angiadevices/Jhankaar/3D Model/MICRO-USB-SMD_10103594-0001LF.step

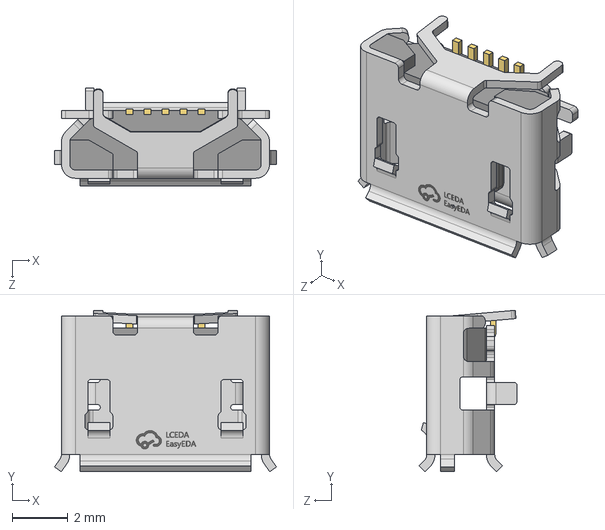
[picture p1: CAD file, 2025-10-25]
3D Model/MICRO-USB-SMD_10103594-0001LF.step
8.00 x 5.82 x 3.52 mm
