angiadevices/Jhankaar/3D Model/PJ-301M-3-B/PJ-301M-3-B.stp

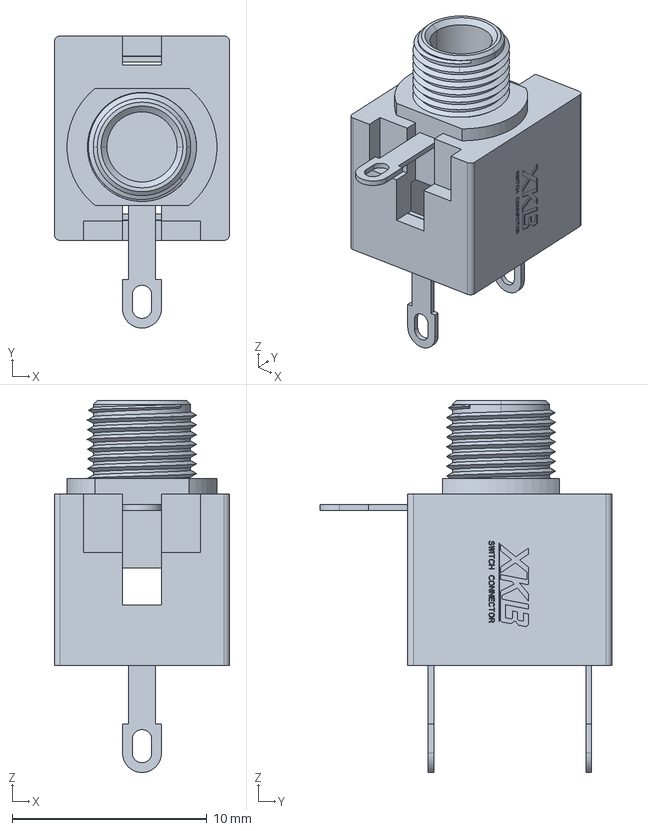
[picture p2: CAD file, 2025-10-25]
3D Model/PJ-301M-3-B/PJ-301M-3-B.stp
9.00 x 15.0 x 19.1 mm
