angiadevices/Jhankaar/3D Model/SW-TH_D6R90F1LFS.step

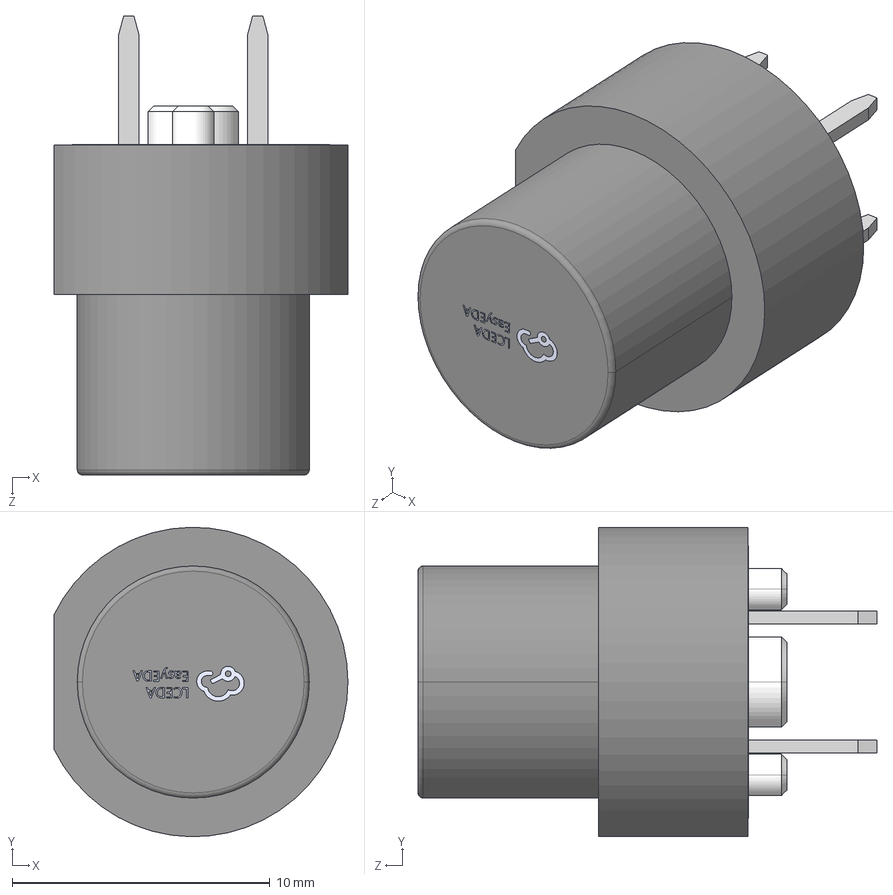
[picture p3: CAD file, 2025-10-25]
3D Model/SW-TH_D6R90F1LFS.step
11.4 x 12.0 x 17.8 mm
