angiadevices/Jhankaar/3D Model/RES-TH_RK09K113004U.step

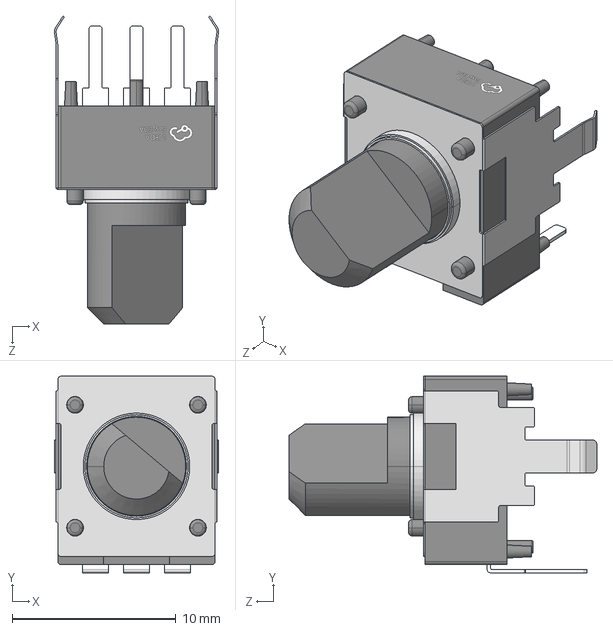
[picture p4: CAD file, 2025-10-25]
3D Model/RES-TH_RK09K113004U.step
10.0 x 12.0 x 18.8 mm
