angiadevices/Jhankaar/3D Model/WQP-PJ398SM.step

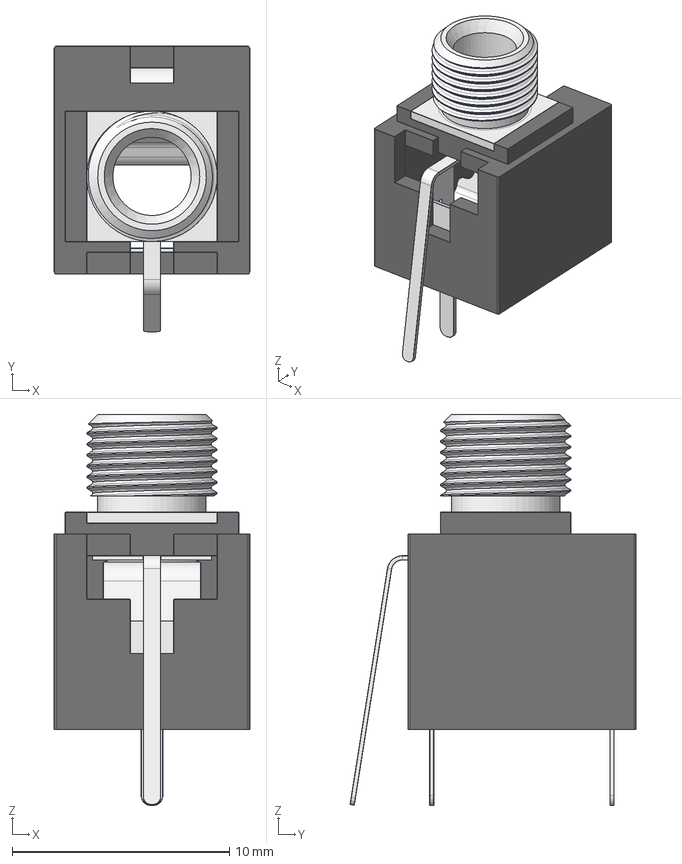
[picture p5: CAD file, 2025-10-25]
3D Model/WQP-PJ398SM.step
9.00 x 13.2 x 18.0 mm
Pin_3
Pin_2
Pin_1
Socket
