angiadevices/Jhankaar/PCB_Ectoscore.kicad_pcb

## KiCad design PCB_Ectoscore.kicad_pcb (2025-10-25)

Schematic: PCB_Ectoscore.kicad_sch

Parts:
C1, C2, C10, C11, C13, C14, C15, C16, C17, C19, C20, C22, C24, C25, C26, C30, C31, C32, C35, C36, C37, C40, C42, C45, C46, C47, C49, C51, C52, C53, C54, C55, C56, C57, C58, C59, C60, C61, C62, C63, C64, C65, C66, C67, C68, C71, C72, C73, C74, C75, C76, C77: 100nF; C_0603_1608Metric_Pad1.08x0.95mm_HandSolder; Manufacturer Part CC0603KRX7R9BB104
C3, C12: 1uF; CP_Elec_4x5.4; Manufacturer Part CA45-A025K105T
C4, C9: 10uF; C_0805_2012Metric; Manufacturer Part GRM21BR61H106KE43L
C5, C6, C48, C50, C69: 10uF; CP_Elec_6.3x5.4; Manufacturer Part RVT1H100M0605
C7, C8: 15pF; C_0603_1608Metric_Pad1.08x0.95mm_HandSolder; Manufacturer Part CC0603KRNPO9BN150
C21, C23: 1uF; C_0603_1608Metric_Pad1.08x0.95mm_HandSolder; Manufacturer Part CC0603KRX7R9BB105
C34, C44, C78, C79, C80: 100pF; C_0603_1608Metric_Pad1.08x0.95mm_HandSolder; Manufacturer Part CC0603KRX7R9BB101
C38, C39: 2.2uF; C_0603_1608Metric_Pad1.08x0.95mm_HandSolder; Manufacturer Part GRM188Z71E225KE43D
C41, C43: 1nF; C_0603_1608Metric_Pad1.08x0.95mm_HandSolder; Manufacturer Part CC0603KRX7R9BB102
C70: 22uF; CP_Elec_6.3x5.4; Manufacturer Part RVT1H220M0605
D1, D2, D3, D24: 1N5819WS; D_SOD-323_HandSoldering; Manufacturer Part 1N5819WS
D5, D6, D7, D8, D9, D10, D11, D12, D13, D14, D15, D16, D17, D18, D19, D20, D21, D22: WS2812B-2020; LED_WS2812B-2020_PLCC4_2.0x2.0mm; Manufacturer Part WS2812B-2020
J1: Conn_02x05_Odd_Even; IDC-Header_2x05_P2.54mm_Vertical; Manufacturer Part ZX-IDC2.54-2-5PZZ
J2: Conn_01x03; PinHeader_1x03_P2.54mm_Vertical; Manufacturer Part PZ254-1-03-Z-8.5
J3, J5, J6, J7, J8, J9, J10, J11: PJ-301M-3-B; Jack_3.5mm_QingPu_WQP-PJ398SM_Vertical; Manufacturer Part PJ-301M-3-B
J12: PJS008U-3000-0; PJS008U30000; Manufacturer_Part_Number PJS008U-3000-0; Mouser Part Number 945-PJS008U-3000-0
J13, J14: Conn_01x03; HDR-TH_3P-P2.54-V-M-1; Manufacturer Part PZ254-1-03-Z-8.5
LED1, LED2, LED3, LED4, LED5, LED6: LED-0603_R; LED0603-R-RD_RED; Part Number PCM5100AQPWRQ1
Q1: MMBT3904; SOT-23; Manufacturer Part MMBT3904LT1G
R1, R2, R5, R29, R36, R42, R47, R50, R57, R58, R64, R81, R82, R83: 1kΩ; R_0603_1608Metric_Pad0.98x0.95mm_HandSolder; Manufacturer Part 0603WAF1001T5E
R3, R4, R8, R52, R55, R71: 10kΩ; R_0603_1608Metric_Pad0.98x0.95mm_HandSolder; Manufacturer Part 0603WAF1002T5E
R6, R9: 1k; R_0603_1608Metric_Pad0.98x0.95mm_HandSolder; Manufacturer Part 0603WAF1001T5E
R7: 0R; R_0603_1608Metric_Pad0.98x0.95mm_HandSolder; Manufacturer Part 0603WAF0000T5E
R10, R15, R68, R69, R70: 10kΩ; POT_TH_Alps_RK09K_Single_Vertical; Manufacturer Part RK09K1130A8G
R27, R28: 27; R_0603_1608Metric_Pad0.98x0.95mm_HandSolder; Manufacturer Part 0603WAF270JT5E
R48, R49: 5.1kΩ; R_0603_1608Metric_Pad0.98x0.95mm_HandSolder; Manufacturer Part 0603WAF5101T5E
R51, R54, R65: 2.2kΩ; R_0603_1608Metric_Pad0.98x0.95mm_HandSolder; Manufacturer Part 0603WAF2201T5E
R53, R56, R72, R77, R80: 33kΩ; R_0603_1608Metric_Pad0.98x0.95mm_HandSolder; Manufacturer Part 0603WAF3302T5E
R59: 200Ω; R_0603_1608Metric_Pad0.98x0.95mm_HandSolder; Manufacturer Part 0603WAF2000T5E
R60, R62: 18kΩ; R_0603_1608Metric_Pad0.98x0.95mm_HandSolder; Manufacturer Part 0603WAF1802T5E
R61, R63: 9.1kΩ; R_0603_1608Metric_Pad0.98x0.95mm_HandSolder; Manufacturer Part 0603WAF9101T5E
R66, R67, R73, R76, R79: 100kΩ; R_0603_1608Metric_Pad0.98x0.95mm_HandSolder; Manufacturer Part 0603WAF1003T5E
R74, R75, R78: 200kΩ; R_0603_1608Metric_Pad0.98x0.95mm_HandSolder; Manufacturer Part 0603WAF2003T5E
SW1, SW2, SW3: TL1105SPF100Q; KEY-TH_4P-L6.0-W6.0-P4.50-LS7.5; Manufacturer Part TL1105SPF100Q
SW4: ML6-H2T2BQA; SW-TH_ML6-H2XX; Manufacturer Part ML6-H2T2BQA
SW5, SW6: SW_Push; SW_SPST_CK_RS282G05A3; Manufacturer Part RS282G05A3SM
TP1, TP2, TP3, TP4, TP5, TP6, TP7, TP8: TestPoint; TestPoint_Pad_D1.5mm; Manufacturer Part N/A; not fitted
U1: L7805; TO-252-2; Manufacturer Part L7805CDT-TR
U2: NCP1117-3.3_SOT223; SOT-223-3_TabPin2; Manufacturer Part NCP1117ST33T3G
U7: W25Q128JVS; SOIC-8_5.3x5.3mm_P1.27mm; Manufacturer Part W25Q128JVSIQ
U11: RP2040; RP2040-QFN-56; Manufacturer Part RP2040
U15: 12402012E212A; USB-SMD_TYPE-C16PIN-1; Manufacturer Part 12402012E212A; LCSC Part C5150972
U16: PCM5100AQPWRQ1; TSSOP-20_4.4x6.5mm_P0.65mm; Manufacturer Part PCM5100AQPWRQ1
U17, U18: TL072HIDR; SOIC-8_3.9x4.9mm_P1.27mm; Manufacturer Part TL072HIDR
U19: TLP2361(TPL,E(T; SO-5-6_4.55x3.7mm_P1.27mm; Manufacturer Part TLP2361(TPL,E(T
U20: MCP3208T-CI/SL; SOIC-16_3.9x9.9mm_P1.27mm; Manufacturer Part MCP3208T-CI/SL
U21: MCP1804x-5002xMB; SOT-89-3; Manufacturer Part MCP1804T-5002I/MB
U22: LM4040DIM3-10.0/NOPB; SOT-23; Manufacturer Part LM4040DIM3-10.0/NOPB
U23: MCP6004T-I/ST; TSSOP-14_4.4x5mm_P0.65mm; Manufacturer Part MCP6004T-I/ST
Y1: ABM8-272-T3; Crystal_SMD_3225-4Pin_3.2x2.5mm; Manufacturer Part ABM8-272-T3

Connections:
3.3V: C9.1, C12.1, C15.1, C22.1, C23.1, C24.1, C25.1, C26.1, C30.1, C31.1, C32.1, C42.2, C49.2, C50.1, C51.2, C52.2, C53.2, C54.2, C55.2, C56.2, C57.2, C58.2, C59.2, C60.2, C61.2, C62.2, C63.2, C64.2, C65.2, C66.2, C67.2, C68.2, D5.4 (VDD), D6.4 (VDD), D7.4 (VDD), D8.4 (VDD), D9.4 (VDD), D10.4 (VDD), D11.4 (VDD), D12.4 (VDD), D13.4 (VDD), D14.4 (VDD), D15.4 (VDD), D16.4 (VDD), D17.4 (VDD), D18.4 (VDD), D19.4 (VDD), D20.4 (VDD), D21.4 (VDD), D22.4 (VDD), J12.4 (VDD), R3.2, R4.2, R7.1, R8.2, R42.1, R47.1, R67.2, R81.1, R82.1, R83.2, TP2.1, U2.2 (VO), U7.8 (VCC), U11.1 (IOVDD), U11.10 (IOVDD), U11.22 (IOVDD), U11.33 (IOVDD), U11.42 (IOVDD), U11.43 (ADC_AVDD), U11.44 (VREG_IN), U11.48 (USB_VDD), U11.49 (IOVDD), U16.11 (FLT), U16.17 (XSMT), U16.20 (DVDD), U19.6 (VDD)
5V: C3.1, D1.2 (A), TP3.1, U1.3 (OUT)
10NEG: C71.2, R65.2, R74.2, R75.2, R78.2, U22.1 (K)
12POS: C10.2, C13.2, C46.2, C47.2, C70.1, D2.1 (K), TP4.1, U1.1 (IN), U17.8 (V+), U18.8 (V+), U21.3 (IN)
+1V1: C19.1, C20.1, C21.1, U11.23 (DVDD), U11.45 (VREG_VOUT), U11.50 (DVDD)
+3V3_A: C17.2, C35.2, C36.2, C48.1, C69.1, C77.2, R10.1, R15.1, R68.1, R69.1, R70.1, TP7.1, U16.1 (CPVDD), U16.8 (AVDD), U20.15 (Vref), U20.16 (Vdd), U21.1 (OUT), U23.4 (V+)
-12V: C11.1, C14.1, C40.2, C45.2, D3.2 (A), R65.1, TP5.1, U17.4 (V-), U18.4 (V-)
/QSPI_SCLK: U7.6 (CLK), U11.52 (QSPI_SCLK)
/QSPI_SD0: U7.5 (DI(IO0)), U11.53 (QSPI_SD0)
/QSPI_SD1: U7.2 (DO(IO1)), U11.55 (QSPI_SD1)
/QSPI_SD2: U7.3 (IO2), U11.54 (QSPI_SD2)
/QSPI_SD3: U7.7 (IO3), U11.51 (QSPI_SD3)
/QSPI_SS: R6.1, R7.2, U7.1 (~CS), U11.56 (QSPI_SS)
/RUN: SW6.2, U11.26 (RUN)
/SWCLK: J13.1, U11.24 (SWCLK)
/SWD: J13.2, U11.25 (SWD)
/USB_D+: R27.1, U15.A6 (D+), U15.B6 (D+)
/USB_D-: R28.1, U15.A7 (D-), U15.B7 (D-)
/XIN: C7.1, U11.20 (XIN), Y1.1
/XOUT: R9.1, U11.21 (XOUT)
/~USB_BOOT: R6.2, SW5.2
ADC_CSN: U11.12 (GPIO9), U20.10 (~CS/SHDN)
ADC_RX: U11.11 (GPIO8), U20.12 (Dout)
ADC_SCLK: U11.13 (GPIO10), U20.13 (CLK)
ADC_TX: U11.14 (GPIO11), U20.11 (Din)
BTN_BANK: C16.2, R5.2, R8.1, U11.31 (GPIO20)
BTN_MODE: C1.2, R1.2, R3.1, U11.2 (GPIO0)
BTN_MULT: C2.2, R2.2, R4.1, U11.3 (GPIO1)
BTN_TAP_TEMPO: SW4.1, SW4.2, U11.4 (GPIO2)
CLOCK_IN: Q1.3 (C), R67.1, U11.17 (GPIO14)
CLOCK_OUT: R29.1, U11.30 (GPIO19), U18.3 (+)
CV_AMEN: C80.1, R80.1, U20.3 (CH2), U23.14
CV_BREAK: C79.1, R77.1, U20.6 (CH5), U23.8
CV_SAMPLE: C78.1, R72.1, U20.8 (CH7), U23.7
DAC_BCK: U11.32 (GPIO21), U16.13 (BCK)
DAC_DIN: U11.35 (GPIO23), U16.14 (DIN)
DAC_LRCK: U11.34 (GPIO22), U16.15 (LRCK)
DAC_OUTL: R51.2, U16.6 (OUTL)
DAC_OUTR: R54.2, U16.7 (OUTR)
GND: C1.1, C2.1, C3.2, C4.2, C5.2, C6.1, C7.2, C8.2, C9.2, C10.1, C11.2, C12.2, C13.1, C14.2, C15.2, C16.1, C17.1, C19.2, C20.2, C21.2, C22.2, C23.2, C24.2, C25.2, C26.2, C30.2, C31.2, C32.2, C35.1, C36.1, C37.1, C39.1, C40.1, C41.1, C42.1, C43.1, C45.1, C46.1, C47.1, C48.2, C49.1, C50.2, C51.1, C52.1, C53.1, C54.1, C55.1, C56.1, C57.1, C58.1, C59.1, C60.1, C61.1, C62.1, C63.1, C64.1, C65.1, C66.1, C67.1, C68.1, C69.2, C70.2, C71.1, C72.1, C73.1, C74.1, C75.1, C76.1, C77.1, D5.2 (VSS), D6.2 (VSS), D7.2 (VSS), D8.2 (VSS), D9.2 (VSS), D10.2 (VSS), D11.2 (VSS), D12.2 (VSS), D13.2 (VSS), D14.2 (VSS), D15.2 (VSS), D16.2 (VSS), D17.2 (VSS), D18.2 (VSS), D19.2 (VSS), D20.2 (VSS), D21.2 (VSS), D22.2 (VSS), J1.3, J1.4, J1.5, J1.6, J1.7, J1.8, J2.3, J3.S, J5.S, J6.S, J7.S, J8.S, J9.S, J10.S, J11.S, J12.6 (VSS), J12.MH1, J12.MH2, J13.3, J14.3, LED1.2 (C), LED2.2 (C), Q1.2 (E), R10.3, R15.3, R48.1, R49.1, R60.1, R62.1, R68.3, R69.3, R70.3, SW1.1, SW1.2, SW2.1, SW2.2, SW3.1, SW3.2, SW4.3, SW4.4, SW5.1, SW6.1, TP1.1, TP6.1, TP8.1, U1.2 (GND), U2.1 (GND), U7.4 (GND), U11.19 (TESTEN), U11.57 (GND), U15.17, U15.18, U15.19, U15.20, U15.A1B12 (GND), U15.B1A12 (GND), U16.3 (CPGND), U16.9 (AGND), U16.10 (DEMP), U16.12 (SCK), U16.16 (FMT), U16.19 (DGND), U17.3 (+), U17.5 (+), U19.4 (GND), U20.9 (DGND), U20.14 (AGND), U21.2 (GND), U22.2 (A), U23.5 (+), U23.10 (+), U23.11 (V-), U23.12 (+), Y1.2, Y1.4
INPUT_DETECT: J9.T, J10.T, J11.T, R71.1, R73.2, R76.2, R79.2
INPUT_DETECT_UNBUFFER: U11.27 (GPIO16), U23.3 (+)
KNOB_AMEN: C76.2, R70.2, U20.1 (CH0)
KNOB_AMEN_ATTEN: C75.2, R69.2, U20.2 (CH1)
KNOB_BREAK: C74.2, R68.2, U20.4 (CH3)
KNOB_GRIMOIRE: C73.2, R10.2, U20.5 (CH4)
KNOB_SAMPLE: C72.2, R15.2, U20.7 (CH6)
LED_MODE1: LED3.2 (C), U11.8 (GPIO6)
LED_MODE2: LED4.2 (C), U11.15 (GPIO12)
LED_MODE3: LED6.2 (C), U11.28 (GPIO17)
LED_MODE4: LED5.2 (C), U11.16 (GPIO13)
LED_TAP_TEMPO: SW4.L2, U11.5 (GPIO3)
MIDI: U11.18 (GPIO15), U19.5 (VO)
unnamed: C8.1, R9.2, Y1.3
unnamed: C34.1, R50.1, R53.1, U17.1
unnamed: C41.2, R51.1, R52.2
unnamed: C43.2, R54.1, R55.2
unnamed: C44.1, R56.1, R57.1, U17.7
unnamed: C4.1, D1.1 (K), D24.1 (K), U2.3 (VI)
unnamed: C5.1, D2.2 (A), J1.9, J1.10
unnamed: C6.2, D3.1 (K), J1.1, J1.2
unnamed: D5.1 (DOUT), D6.3 (DIN)
unnamed: D6.1 (DOUT), D7.3 (DIN)
unnamed: D7.1 (DOUT), D8.3 (DIN)
unnamed: D8.1 (DOUT), D9.3 (DIN)
unnamed: D9.1 (DOUT), D10.3 (DIN)
unnamed: D10.1 (DOUT), D11.3 (DIN)
unnamed: D11.1 (DOUT), D12.3 (DIN)
unnamed: D12.1 (DOUT), D13.3 (DIN)
unnamed: D13.1 (DOUT), D14.3 (DIN)
unnamed: D14.1 (DOUT), D15.3 (DIN)
unnamed: D15.1 (DOUT), D16.3 (DIN)
unnamed: D16.1 (DOUT), D17.3 (DIN)
unnamed: D17.1 (DOUT), D18.3 (DIN)
unnamed: D18.1 (DOUT), D19.3 (DIN)
unnamed: D19.1 (DOUT), D20.3 (DIN)
unnamed: D20.1 (DOUT), D21.3 (DIN)
unnamed: D21.1 (DOUT), D22.3 (DIN)
unnamed: J2.1, U19.3 (K)
unnamed: J2.2, R59.1
unnamed: J3.T, R58.2
unnamed: J5.T, R50.2
unnamed: J6.T, R57.2
unnamed: J7.T, R64.2
unnamed: J8.T, R66.2
unnamed: LED1.1 (A), R29.2
unnamed: LED2.1 (A), R36.2
unnamed: LED3.1 (A), R42.2
unnamed: LED4.1 (A), R47.2
unnamed: LED5.1 (A), R81.2
unnamed: LED6.1 (A), R82.2
unnamed: Q1.1 (B), R66.1
unnamed: R1.1, SW1.3, SW1.4
unnamed: R2.1, SW2.3, SW2.4
unnamed: R5.1, SW3.3, SW3.4
unnamed: R48.2, U15.A5 (CC1)
unnamed: R49.2, U15.B5 (CC1)
unnamed: R58.1, R61.2, U18.1
unnamed: R63.2, R64.1, U18.7
unnamed: R83.1, SW4.L1
unnamed: R28.2, U11.46 (USB_DM)
unnamed: R27.2, U11.47 (USB_DP)
unnamed: C38.1, U16.4 (CAPM)
unnamed: C38.2, U16.2 (CAPP)
unnamed: C37.2, U16.18 (LDOO)
unnamed: C39.2, U16.5 (VNEG)
unnamed: C34.2, R52.1, R53.2, U17.2 (-)
unnamed: C44.2, R55.1, R56.2, U17.6 (-)
unnamed: R60.2, R61.1, U18.2 (-)
unnamed: R62.2, R63.1, U18.6 (-)
unnamed: R59.2, U19.1 (A)
unnamed: R71.2, U23.1, U23.2 (-)
unnamed: C78.2, R72.2, R73.1, R74.1, U23.6 (-)
unnamed: C79.2, R75.1, R76.1, R77.2, U23.9 (-)
unnamed: C80.2, R78.1, R79.1, R80.2, U23.13 (-)
SCL: J14.2, U11.7 (GPIO5)
SDA: J14.1, U11.6 (GPIO4)
SD_CMD: J12.3 (CMD), U11.37 (GPIO25)
SD_DAT0: J12.7 (DAT0), U11.38 (GPIO26_ADC0)
SD_DAT1: J12.8 (DAT1), U11.39 (GPIO27_ADC1)
SD_DAT2: J12.1 (DAT2), U11.40 (GPIO28_ADC2)
SD_DAT3: J12.2 (DAT3/CD), U11.41 (GPIO29_ADC3)
SD_SCLK: J12.5 (CLK), U11.36 (GPIO24)
TRIG_OUT: R36.1, U11.29 (GPIO18), U18.5 (+)
VBUS: D24.2 (A), U15.A4B9 (VBUS), U15.B4A9 (VBUS)
WS2812: D5.3 (DIN), U11.9 (GPIO7)

Notes on the sheet:
Thonkiconn
Shunt Voltage Reference IC Fixed 10V V ±1% 15 mA
Audio Stereo DAC with 32-bit, 384kHz PCM Interface
Make sure R3 and R4 are close to RP2040
LED RGB WS2812
SAMPLE
Crystal
CLOCK OUT
PJ-301M-3-B
SD CARD
OUT_R
AMEN
Flash
OUT_L
USB TYPE C
Eurorack Power In
RP2040
BREAK
Make sure C10 is close to pin 44 of RP2040
ADC
MIDI (optional)
Power
CLOCK IN
Buttons
Make sure C8 is close to pin 45 of RP2040
TRIG OUT

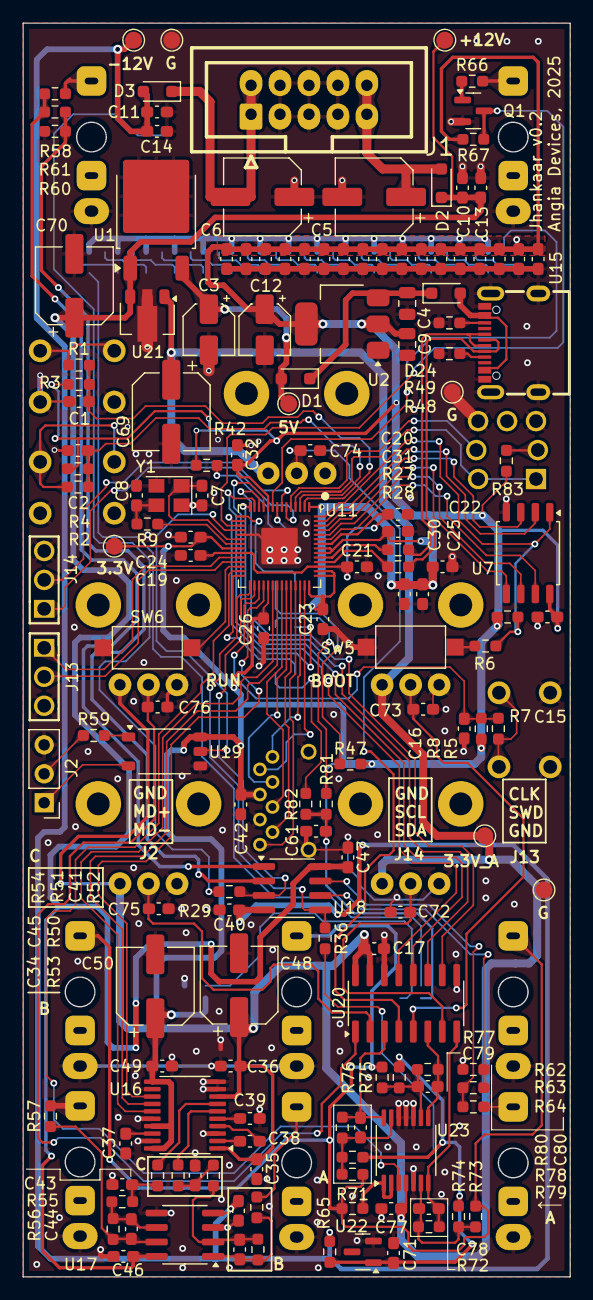
[picture p6: board PCB_Ectoscore.kicad_pcb from above]

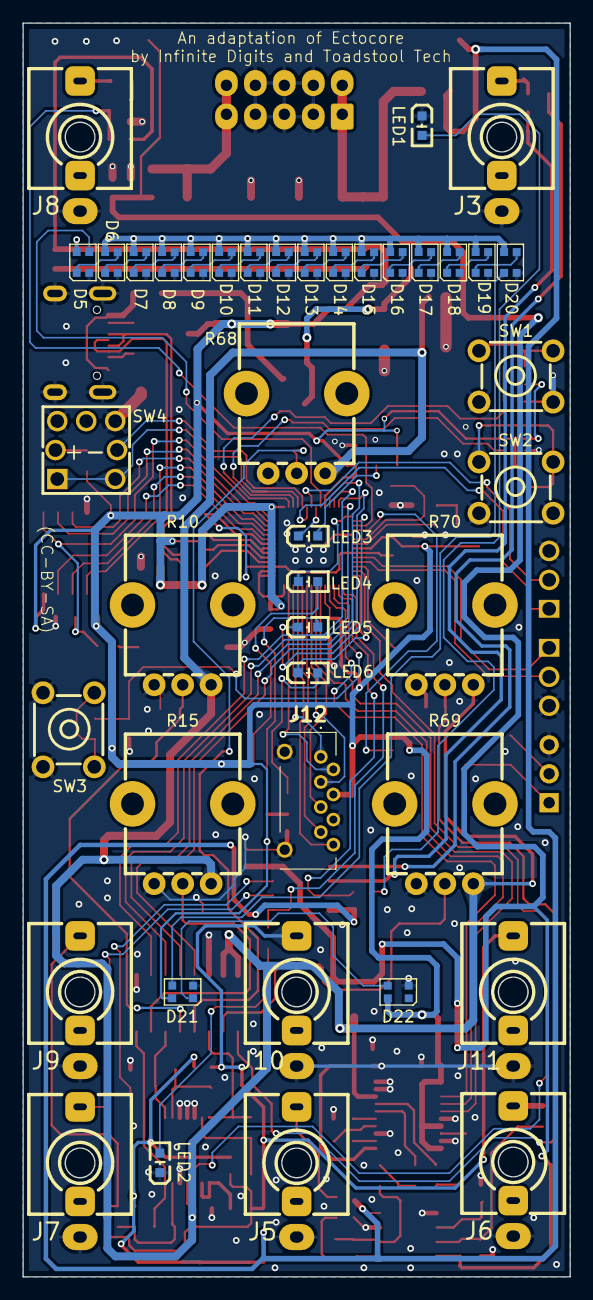
[picture p7: board PCB_Ectoscore.kicad_pcb from below]

Board: 2 copper layers, 48.0 x 110.0 mm, 198 parts (42 on the bottom side), 126 nets.
